robinjosef/Prototyp_testovani_ladeni_emr_epd/Digitiyer_demo_1V8_module.kicad_pcb

## KiCad design Digitiyer_demo_1V8_module.kicad_pcb (2026-08-08)

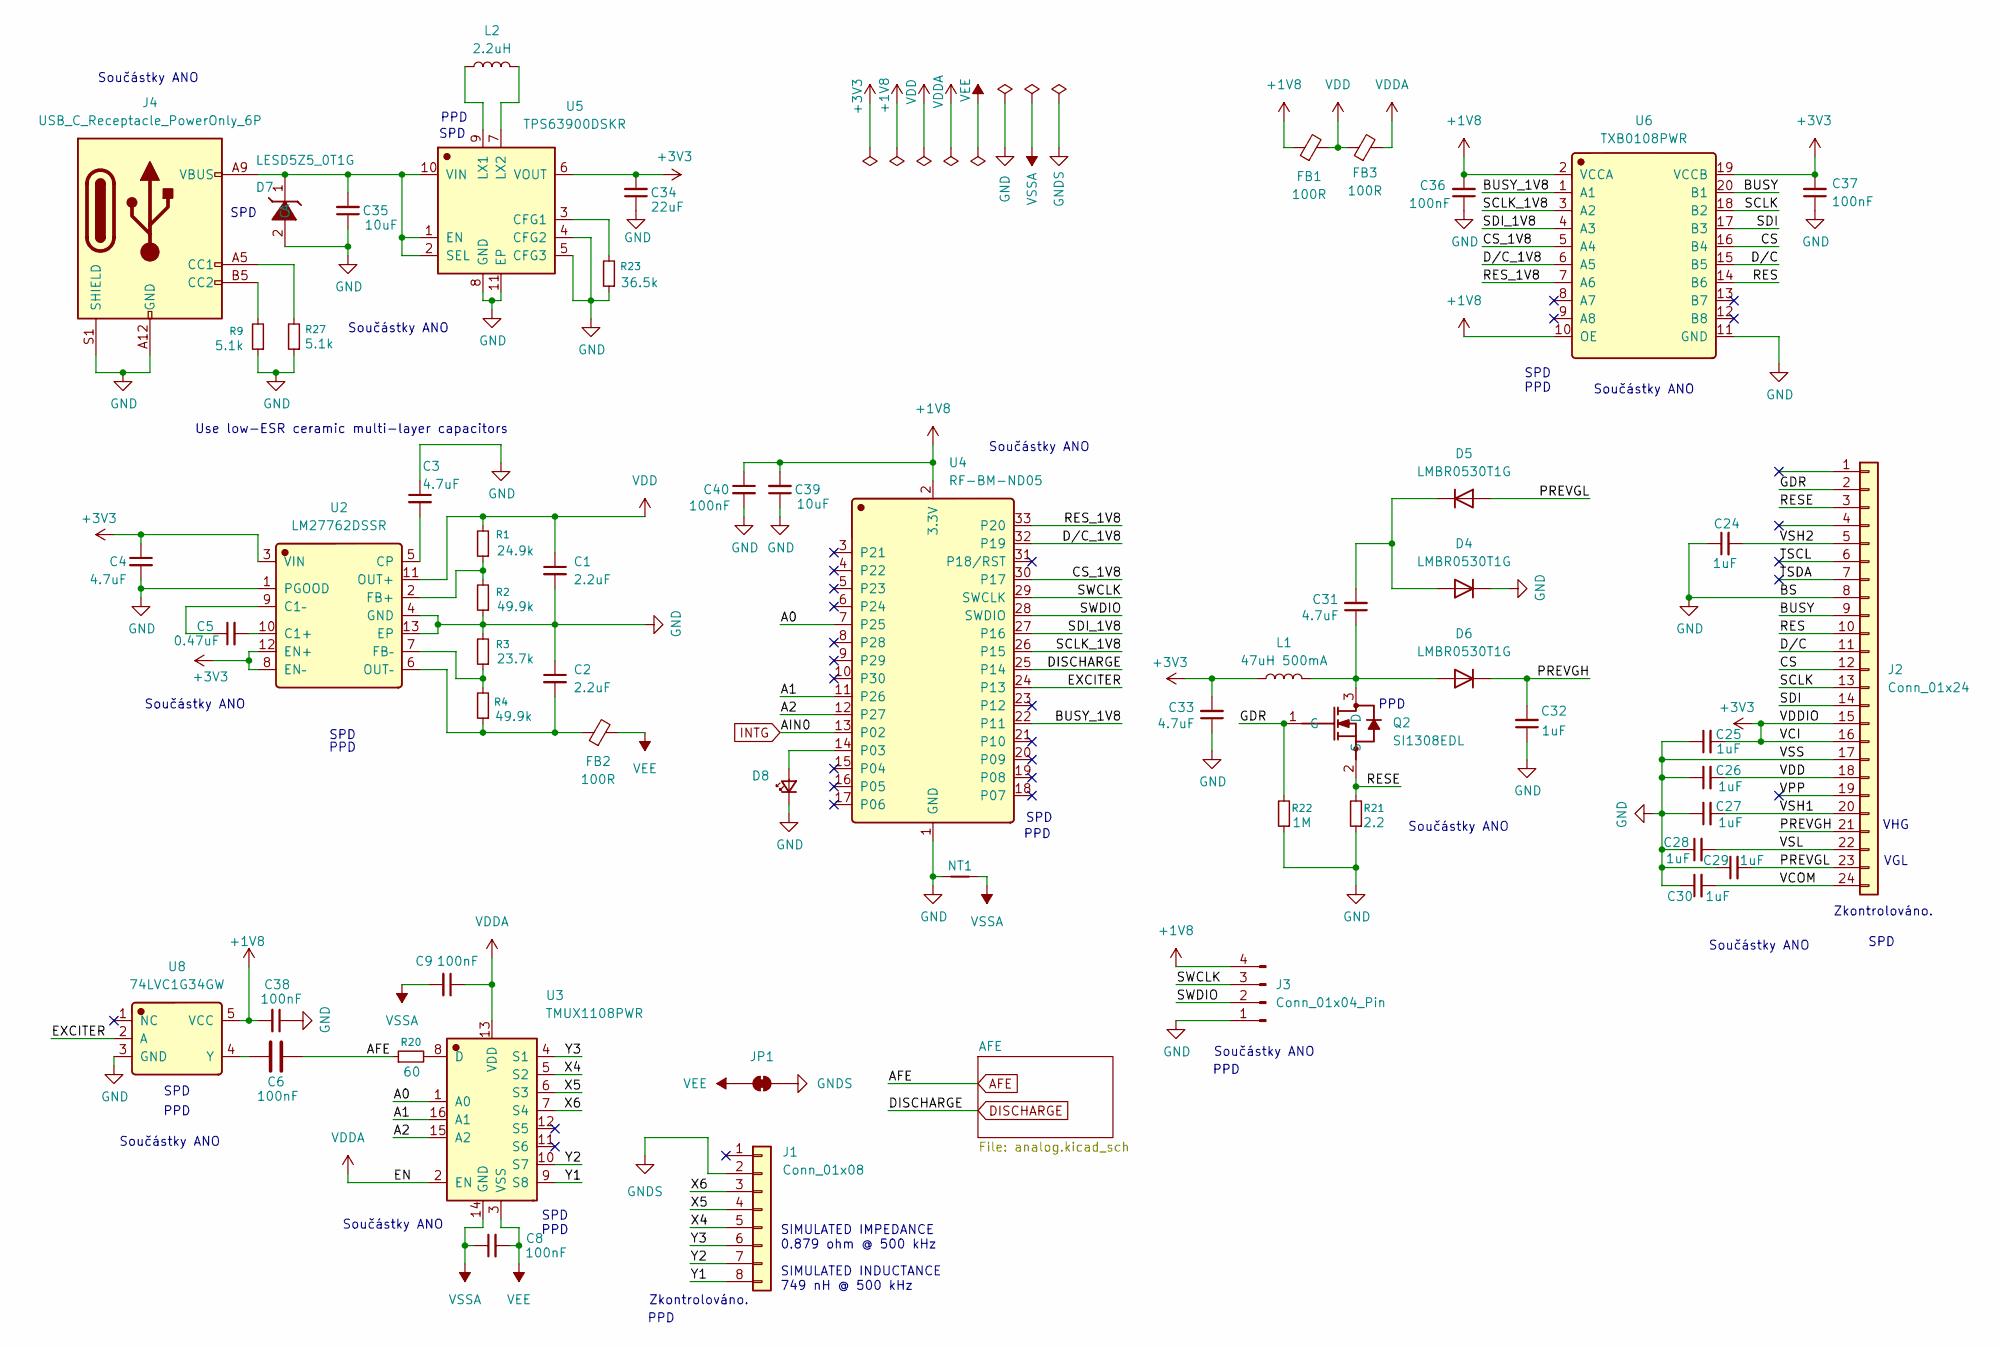
[picture p1: schematic Digitiyer_demo_1V8_module.kicad_sch]

Parts:
C1, C2: 2.2uF; C_0402_1005Metric
C3, C4: 4.7uF; C_0402_1005Metric
C5: 0.47uF; C_0603_1608Metric
C6: 100nF; C_0603_1608Metric_Pad1.08x0.95mm_HandSolder
C8, C9, C38, C40: 100nF; C_0603_1608Metric
C24, C25, C26, C27, C28, C29, C30, C32: 1uF; C_0603_1608Metric
C31, C33: 4.7uF; C_0805_2012Metric
C34: 22uF; C_0603_1608Metric
C35, C39: 10uF; C_0402_1005Metric
C36, C37: 100nF; C_0402_1005Metric
D4, D5, D6: LMBR0530T1G; D_SOD-123
D7: LESD5Z5_0T1G; D_SOD-523; Manufacturer Part LESD5Z5.0T1G; LCSC C136171
D8: LED_Small; LED_0603_1608Metric
FB1, FB2, FB3: 100R; L_0805_2012Metric
J1: Conn_01x08; FPC-05F-8PH20
J2: Conn_01x24; FPC-0_5FX-24PWBH15
J3: Conn_01x04_Pin; PinHeader_1x04_P2.54mm_Vertical
J4: USB_C_Receptacle_PowerOnly_6P; USB_C_Receptacle_HRO_TYPE-C-31-M-17
JP1: SolderJumper_2_Bridged; SolderJumper-2_P1.3mm_Bridged2Bar_Pad1.0x1.5mm
L1: 47uH 500mA; L_Wuerth_MAPI-3015
L2: 2.2uH; L_1008_2520Metric
NT1: NetTie_2; NetTie-2_SMD_Pad0.5mm
Q2: SI1308EDL; SOT-323_SC-70_Handsoldering; Manufacturer Part SI1308EDL-VB; LCSC C4355112
R1: 24.9k; R_0603_1608Metric
R2, R4: 49.9k; R_0603_1608Metric
R3: 23.7k; R_0603_1608Metric
R9, R27: 5.1k; R_0402_1005Metric
R20: 60; R_0603_1608Metric
R21: 2.2; R_0603_1608Metric
R22: 1M; R_0603_1608Metric
R23: 36.5k; R_0603_1608Metric_Pad0.98x0.95mm_HandSolder
U2: LM27762DSSR; WSON-12-1EP_3x2mm_P0.5mm_EP1x2.65; Manufacturer Part LM27762DSSR; LCSC C473398
U3: TMUX1108PWR; TSSOP-16_4.4x5mm_P0.65mm; Manufacturer Part TMUX1108PWR; LCSC C1021800
U4: RF-BM-ND05; Manufacturer Part RF-BM-ND05; LCSC C5187534
U5: TPS63900DSKR; Manufacturer Part TPS63900DSKR; LCSC C1518762
U6: TXB0108PWR; TSSOP-20_4.4x6.5mm_P0.65mm; Manufacturer Part TXB0108PWR; LCSC C53406
U8: 74LVC1G34GW; SOT-353_SC-70-5; Manufacturer Part 74LVC1G34GW; LCSC C52140426

Connections:
+1V8: C36.2, C38.2, C39.2, C40.1, FB1.1, J3.4, U4.2 (3.3V), U6.2 (VCCA), U6.10 (OE), U8.5 (VCC)
+3V3: C4.1, C25.2, C33.2, C34.2, C37.2, J2.15, J2.16, L1.1, U2.3 (VIN), U2.8 (EN–), U2.12 (EN+), U5.6 (VOUT), U6.19 (VCCB)
/A0: U3.1 (A0), U4.7 (P25)
/A1: U3.16 (A1), U4.11 (P26)
/A2: U3.15 (A2), U4.12 (P27)
/BUSY: J2.9, U6.20 (B1)
/BUSY_1V8: U4.22 (P11), U6.1 (A1)
/CS: J2.12, U6.16 (B4)
/CS_1V8: U4.30 (P17), U6.5 (A4)
/D/C: J2.11, U6.15 (B5)
/D/C_1V8: U4.32 (P19), U6.6 (A5)
/EXCITER: U4.24 (P13), U8.2 (A)
/GDR: J2.2, Q2.1 (G), R22.2
/PREVGH: C32.2, D6.1 (K), J2.21
/PREVGL: C29.2, D5.2 (A), J2.23
/RES: J2.10, U6.14 (B6)
/RESE: J2.3, Q2.2 (S), R21.2
/RES_1V8: U4.33 (P20), U6.7 (A6)
/SCLK: J2.13, U6.18 (B2)
/SCLK_1V8: U4.26 (P15), U6.3 (A2)
/SDI: J2.14, U6.17 (B3)
/SDI_1V8: U4.27 (P16), U6.4 (A3)
/SWCLK: J3.3, U4.29 (SWCLK)
/SWDIO: J3.2, U4.28 (SWDIO)
/TSCL: J2.6
/TSDA: J2.7
/VCOM: C30.2, J2.24
/VPP: J2.19
/VSH1: C27.2, J2.20
/VSH2: C24.2, J2.5
/VSL: C28.2, J2.22
/X4: J1.5, U3.5 (S2)
/X5: J1.4, U3.6 (S3)
/X6: J1.3, U3.7 (S4)
/Y1: J1.8, U3.9 (S8)
/Y2: J1.7, U3.10 (S7)
/Y3: J1.6, U3.4 (S1)
AFE: C6.2, R20.1; also elsewhere on the board
DISCHARGE: U4.25 (P14); also elsewhere on the board
GND: C1.2, C2.1, C3.1, C4.2, C24.1, C25.1, C26.1, C27.1, C28.1, C29.1, C30.1, C32.1, C33.1, C34.1, C35.1, C36.1, C37.1, C38.1, C39.1, C40.2, D4.1 (K), D7.2 (A), D8.1 (K), J2.8, J2.17, J3.1, J4.A12 (GND), J4.B12 (GND), J4.S1 (SHIELD), NT1.1, R2.1, R3.2, R9.1, R21.1, R22.1, R23.1, R27.1, U2.1 (PGOOD), U2.4 (GND), U2.13 (EP), U4.1 (GND), U5.4 (CFG2), U5.5 (CFG3), U5.8 (GND), U5.11 (EP), U6.11 (GND), U8.3 (GND)
GNDS: J1.2, JP1.2 (B)
INTG: U4.13 (P02); also elsewhere on the board
unnamed: C31.2, D4.2 (A), D5.1 (K)
unnamed: C31.1, D6.2 (A), L1.2, Q2.3 (D)
unnamed: C35.2, D7.1 (C), J4.A9 (VBUS), J4.B9 (VBUS), U5.1 (EN), U5.2 (SEL), U5.10 (VIN)
unnamed: D8.2 (A), U4.14 (P03)
unnamed: J4.A5 (CC1), R27.2
unnamed: J4.B5 (CC2), R9.2
unnamed: C5.2, U2.10 (C1+)
unnamed: C5.1, U2.9 (C1–)
unnamed: C3.2, U2.5 (CP)
unnamed: R1.1, R2.2, U2.2 (FB+)
unnamed: R3.1, R4.2, U2.7 (FB–)
unnamed: C2.2, FB2.1, R4.1, U2.6 (OUT–)
unnamed: R20.2, U3.8 (D)
unnamed: R23.2, U5.3 (CFG1)
unnamed: L2.1, U5.9 (LX1)
unnamed: L2.2, U5.7 (LX2)
unnamed: C6.1, U8.4 (Y)
VDD: C1.1, C26.2, FB1.2, FB3.1, J2.18, R1.2, U2.11 (OUT+)
VDDA: C9.1, FB3.2, U3.2 (EN), U3.13 (VDD); also elsewhere on the board
VEE: C8.2, FB2.2, JP1.1 (A), U3.3 (VSS); also elsewhere on the board
VSSA: C8.1, C9.2, NT1.2, U3.14 (GND); also elsewhere on the board

Notes on the sheet:
PPD
Součástky ANO
SPD
VGL
Use low-ESR ceramic multi-layer capacitors
SIMULATED INDUCTANCE 749 nH @ 500 kHz
Zkontrolováno.
VHG
SIMULATED IMPEDANCE 0.879 ohm @ 500 kHz

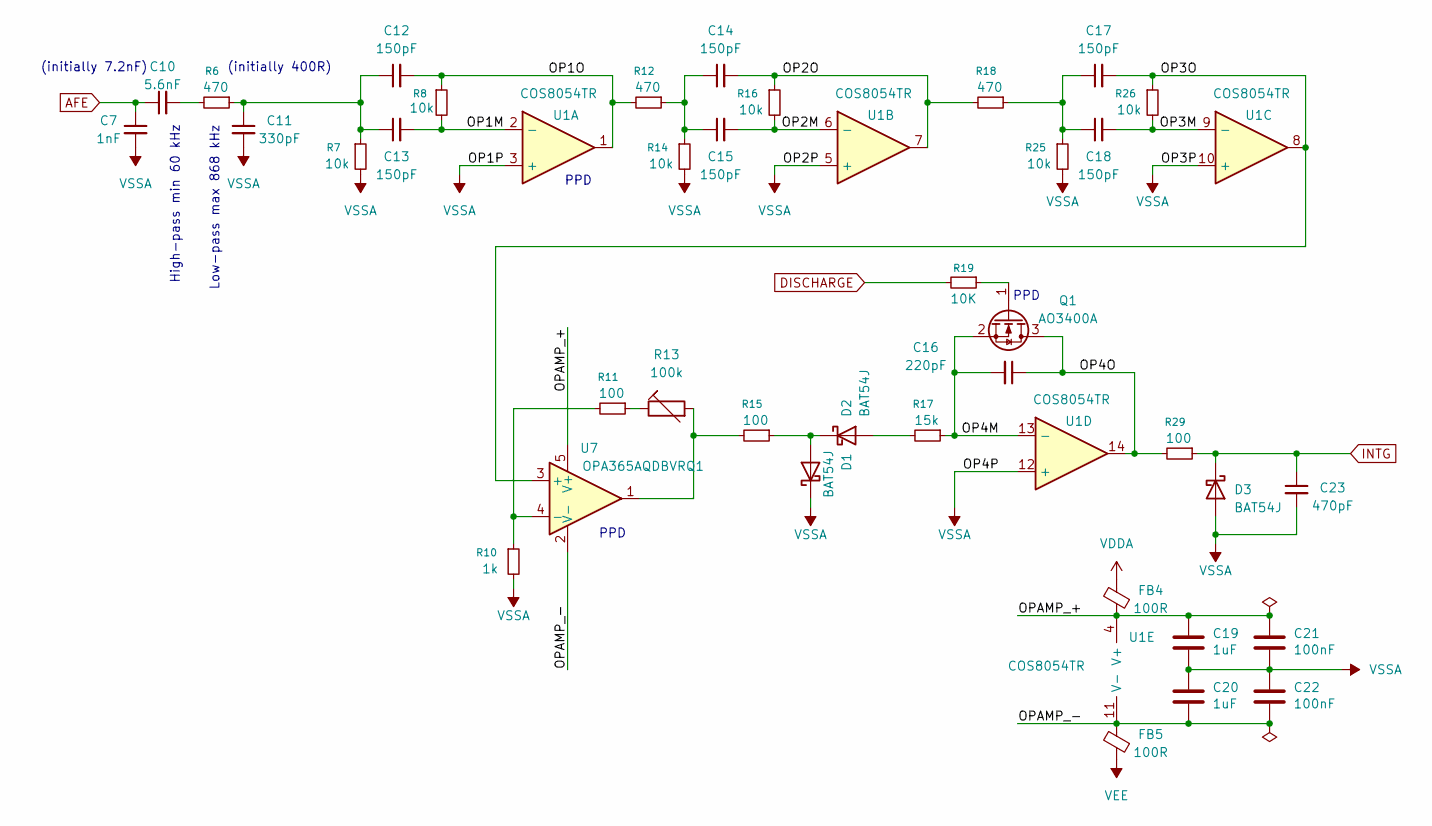
[picture p2: schematic analog.kicad_sch]

Parts:
C7: 1nF; C_0402_1005Metric
C10: 5.6nF; C_0603_1608Metric_Pad1.08x0.95mm_HandSolder
C11: 330pF; C_0603_1608Metric
C12, C13, C14, C15, C17, C18: 150pF; C_0603_1608Metric
C16: 220pF; C_0402_1005Metric
C19, C20: 1uF; C_0603_1608Metric
C21, C22: 100nF; C_0603_1608Metric
C23: 470pF; C_0603_1608Metric
D1, D2, D3: BAT54J; D_SOD-323F
FB4, FB5: 100R; L_0805_2012Metric
Q1: AO3400A; SOT-23
R6, R12, R18: 470; R_0402_1005Metric
R7, R8, R14, R16, R25, R26: 10k; R_0805_2012Metric
R10: 1k; R_0402_1005Metric
R11, R15, R29: 100; R_0402_1005Metric
R13: 100k; Potentiometer_Bourns_3314J_Vertical
R17: 15k; R_0402_1005Metric
R19: 10K; R_0805_2012Metric
U1: COS8054TR; TSSOP-14_4.4x5mm_P0.65mm
U7: OPA365AQDBVRQ1; SOT-23-5_HandSoldering

Connections:
/AFE/OP1M: C13.2, R8.2, U1.2 (-)
/AFE/OP1O: C12.2, R8.1, R12.2, U1.1
/AFE/OP2M: C15.2, R16.2, U1.6 (-)
/AFE/OP2O: C14.2, R16.1, R18.2, U1.7
/AFE/OP3M: C18.2, R26.2, U1.9 (-)
/AFE/OP3O: C17.2, R26.1, U1.8, U7.3 (+)
/AFE/OP4M: C16.2, Q1.2 (S), R17.1, U1.13 (-)
/AFE/OP4O: C16.1, Q1.3 (D), R29.2, U1.14
/AFE/OPAMP_+: C19.1, C21.1, FB4.1, U1.4 (V+), U7.5 (V+)
/AFE/OPAMP_-: C20.2, C22.2, FB5.2, U1.11 (V-), U7.2 (V-)
AFE: C7.1, C10.1; also elsewhere on the board
DISCHARGE: R19.2; also elsewhere on the board
INTG: C23.1, D3.1 (K), R29.1; also elsewhere on the board
unnamed: C10.2, R6.2
unnamed: C11.1, C12.1, C13.1, R6.1, R7.1
unnamed: C14.1, C15.1, R12.1, R14.1
unnamed: C17.1, C18.1, R18.1, R25.1
unnamed: D1.2 (A), D2.1 (K), R15.1
unnamed: D2.2 (A), R17.2
unnamed: Q1.1 (G), R19.1
unnamed: R11.1, R13.1
unnamed: R13.2, R15.2, U7.1
unnamed: R10.1, R11.2, U7.4 (-)
VDDA: FB4.2; also elsewhere on the board
VEE: FB5.1; also elsewhere on the board
VSSA: C7.2, C11.2, C19.2, C20.1, C21.2, C22.1, C23.2, D1.1 (K), D3.2 (A), R7.2, R10.2, R14.2, R25.2, U1.3 (+), U1.5 (+), U1.10 (+), U1.12 (+); also elsewhere on the board

Notes on the sheet:
PPD
High-pass min 60 kHz
Low-pass max 868 kHz
(initially 400R)
(initially 7.2nF)

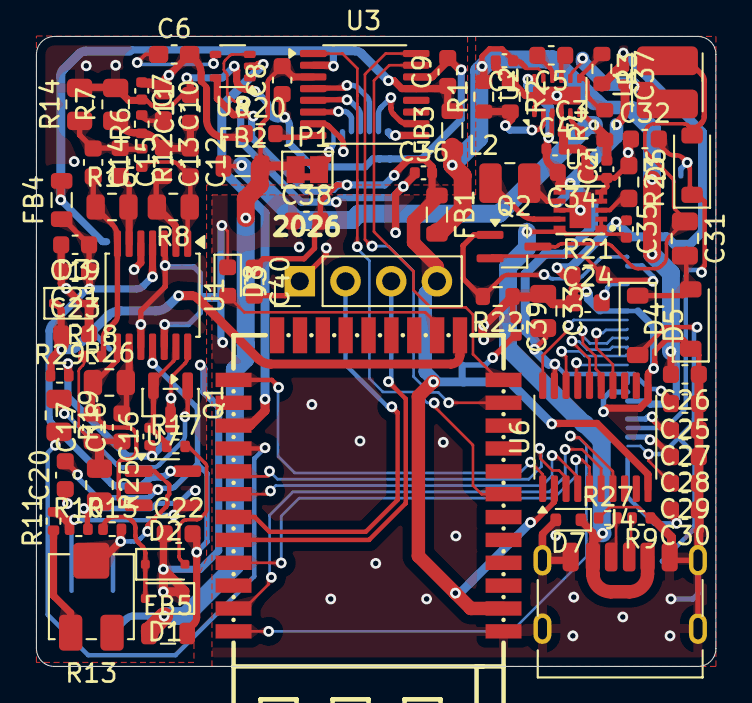
[picture p3: board Digitiyer_demo_1V8_module.kicad_pcb from above]

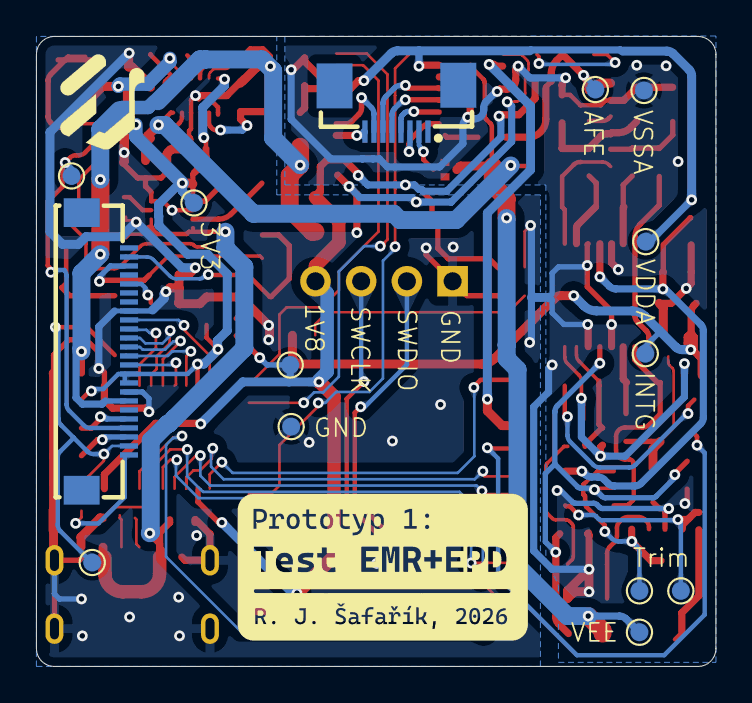
[picture p4: board Digitiyer_demo_1V8_module.kicad_pcb from below]

Board: 2 copper layers, 37.8 x 35.0 mm, 97 parts (3 on the bottom side), 80 nets.
