robinjosef/Prototyp_testovani_ladeni_emr_epd/(commit log)

2026-08-04 přidáné soborí
    [Digitiyer_demo_1V8_module.kicad_pcb, Digitiyer_demo_1V8_module.kicad_sch, analog.kicad_sch]
2026-08-06 uložení
    [Digitiyer_demo_1V8_module.kicad_pcb, Digitiyer_demo_1V8_module.kicad_sch]
2026-08-06 uložit
    [Digitiyer_demo_1V8_module.kicad_pcb, Digitiyer_demo_1V8_module.kicad_sch, analog.kicad_sch]
2026-08-06 nové uložení
    [Digitiyer_demo_1V8_module.kicad_pcb, Digitiyer_demo_1V8_module.kicad_sch]
2026-08-07 uložitt
    [Digitiyer_demo_1V8_module.kicad_pcb, Digitiyer_demo_1V8_module.kicad_sch, analog.kicad_sch]
2026-08-08 finální uložení?
    [Digitiyer_demo_1V8_module.kicad_pcb, Digitiyer_demo_1V8_module.kicad_sch, analog.kicad_sch]
